ranaud80/Boitier-ESP32APRS_Audio/ESP32DR Simple/images/controle_ouvertures.png

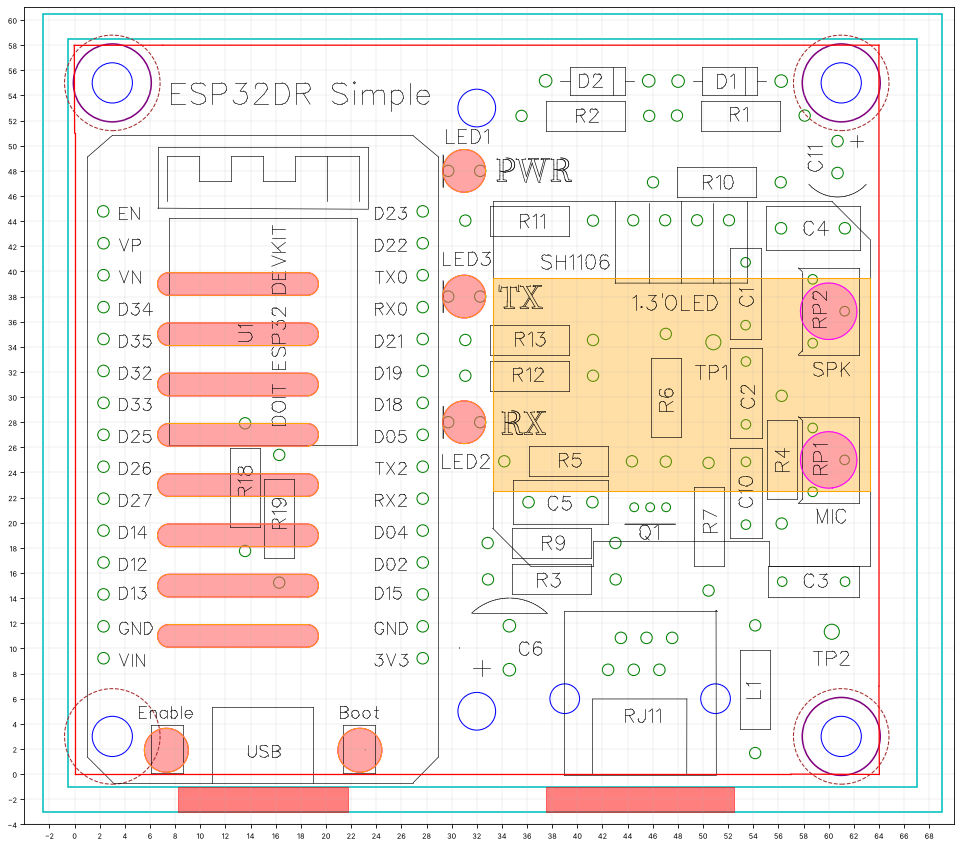
ESP32DR Simple/images/controle_ouvertures.png
