ranaud80/Boitier-ESP32APRS_Audio/ESP32DR Simple/stl/esp32dr_lettres_sans_oled.stl

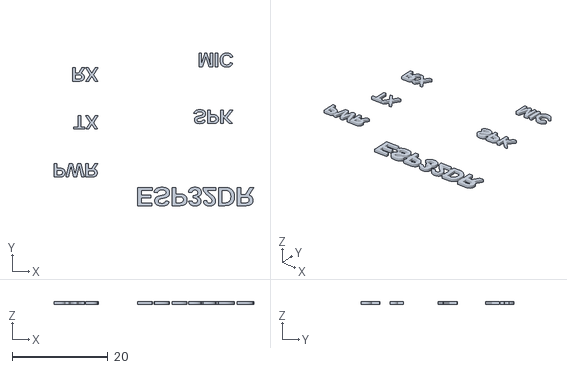
[picture p6: CAD file, 2026-10-10]
ESP32DR Simple/stl/esp32dr_lettres_sans_oled.stl
41.8 x 32.0 x 0.6
