ranaud80/Boitier-ESP32APRS_Audio/ESP32DR Simple/stl/esp32dr_lettres_oled.stl

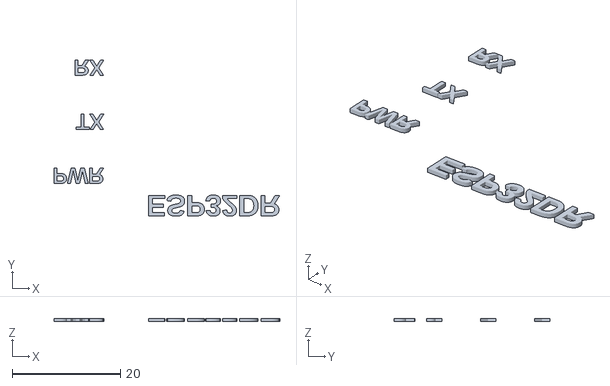
[picture p9: CAD file, 2026-10-10]
ESP32DR Simple/stl/esp32dr_lettres_oled.stl
41.8 x 28.9 x 0.6
