ranaud80/Boitier-ESP32APRS_Audio/ESP32DR Simple/stl/esp32dr_couvercle_oled_esp32_soude.stl

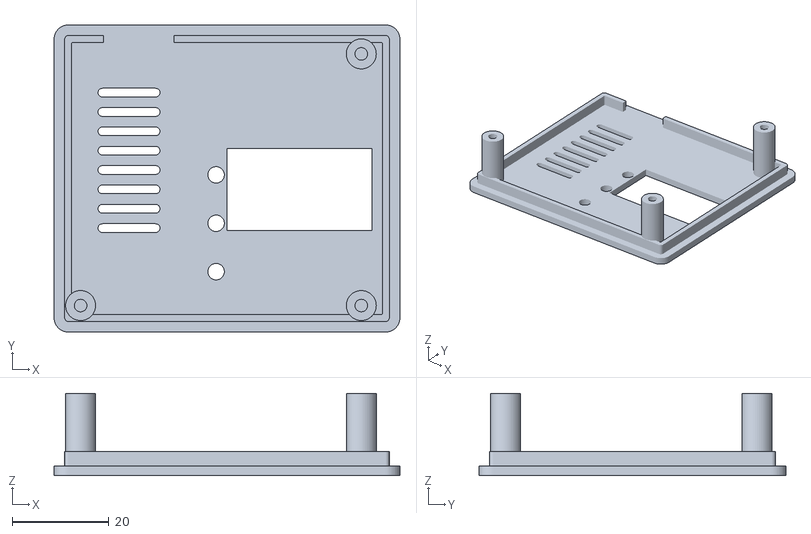
[picture p10: CAD file, 2026-10-10]
ESP32DR Simple/stl/esp32dr_couvercle_oled_esp32_soude.stl
71.5 x 63.5 x 17.0
