ranaud80/Boitier-ESP32APRS_Audio/ESP32DR Simple/stl/esp32dr_couvercle_oled.stl

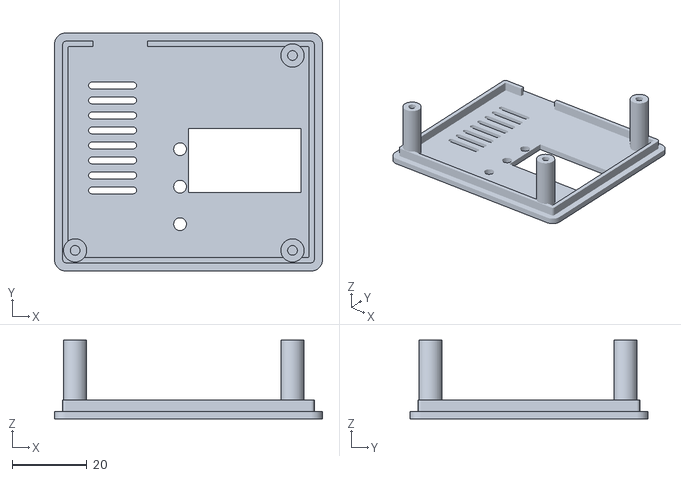
[picture p11: CAD file, 2026-10-10]
ESP32DR Simple/stl/esp32dr_couvercle_oled.stl
71.5 x 63.5 x 21.0
