ranaud80/Boitier-ESP32APRS_Audio/ESP32DR Simple/stl/esp32dr_fond.stl

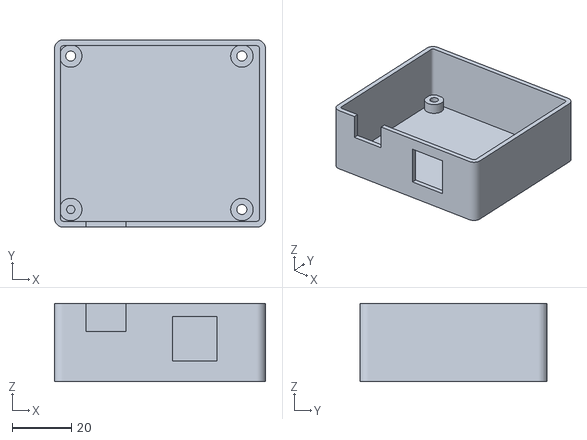
[picture p13: CAD file, 2026-10-10]
ESP32DR Simple/stl/esp32dr_fond.stl
71.5 x 63.5 x 26.6
