ranaud80/Boitier-ESP32APRS_Audio/(commit log)

2026-10-10 Ajoute le boîtier imprimable 3D de la carte ESP32DR Simple
    Source OpenSCAD paramétrique, STL du fond et des couvercles
    (avec ou sans afficheur OLED, ESP32 enfiché ou soudé), aperçus
    et README liés au projet nakhonthai/ESP32APRS_Audio.
    Claude-Session: https://claude.ai/code/session_01DTdBCkhBip44dWwkqx4AM9
    [boitier_esp32dr_simple.scad, esp32dr_couvercle_oled.stl, esp32dr_couvercle_oled_esp32_soude.stl, esp32dr_couvercle_sans_oled.stl, esp32dr_couvercle_sans_oled_esp32_soude.stl, esp32dr_fond.stl, esp32dr_fond_esp32_soude.stl]
2026-10-10 Ajoute la licence CC BY-SA 4.0 et la mention du contenu généré par IA
    L'image de contrôle dérivée des Gerber reste sous GPL-3.0,
    comme le projet d'origine.
    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
    [boitier_esp32dr_simple.scad]
2026-10-10 ESP32DR Simple v3 : inscriptions bicolores
    Gravure portée à 0,6 mm (3 couches de 0,2 mm) pour un changement
    de couleur à l'impression, fichiers de lettres pour l'incrustation
    multimatériau, README mis à jour (couvercle sans afficheur validé).
    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
    [boitier_esp32dr_simple.scad, esp32dr_couvercle_oled.stl, esp32dr_couvercle_oled_esp32_soude.stl, esp32dr_couvercle_sans_oled.stl, esp32dr_couvercle_sans_oled_esp32_soude.stl, esp32dr_lettres_oled.stl, esp32dr_lettres_sans_oled.stl]
